khyale/petitAVR/20140113_134701.jpg

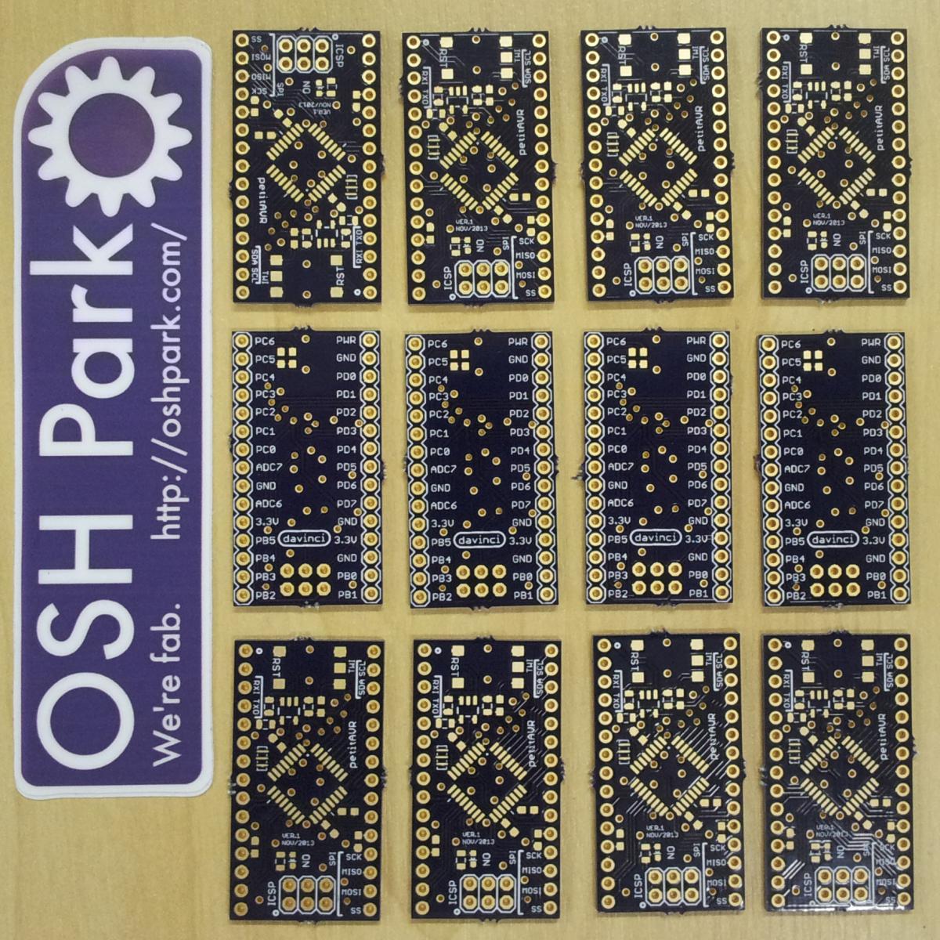
20140113_134701.jpg
