khyale/petitAVR/board-bottom.png

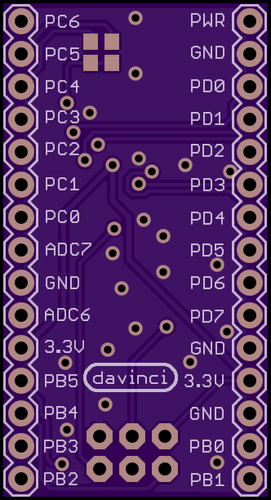
board-bottom.png
