khyale/petitAVR/board-top.png

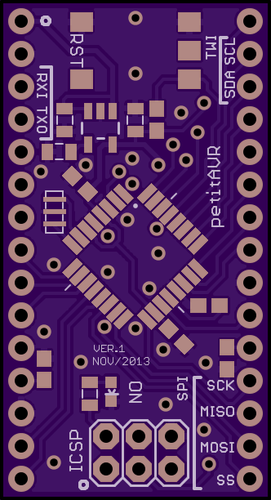
board-top.png
