khyale/petitAVR/circuit.pdf

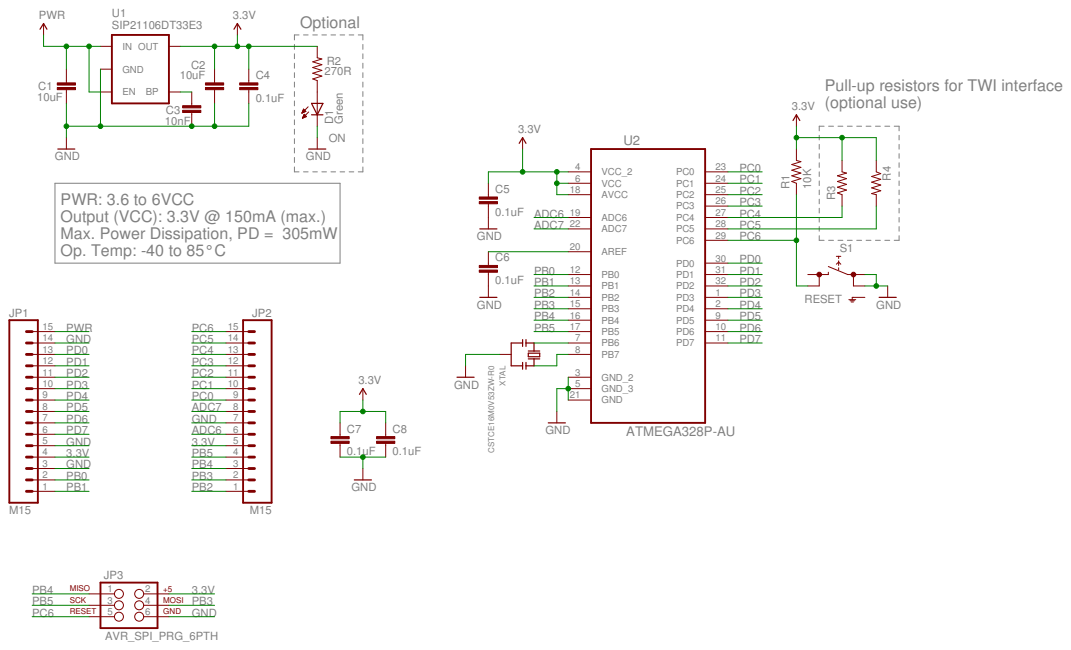
[picture p4: page 1]

PWR: 3.6 to 6VCC
Output (VCC): 3.3V @ 150mA (max.)
Max. Power Dissipation, PD = 305mW
Op. Temp: -40 to 85°C

Davinci Electronic Systems Author: Khyale

20/11/13 16:56 f=0.70 /home/khyale/projetos/petitAVR/board/petitAVR-v1.sch (Sheet: 1/1)
