khyale/petitAVR/eagle/petitAVR-v1.brd

## EAGLE design eagle/petitAVR-v1.brd (2013-11-20)

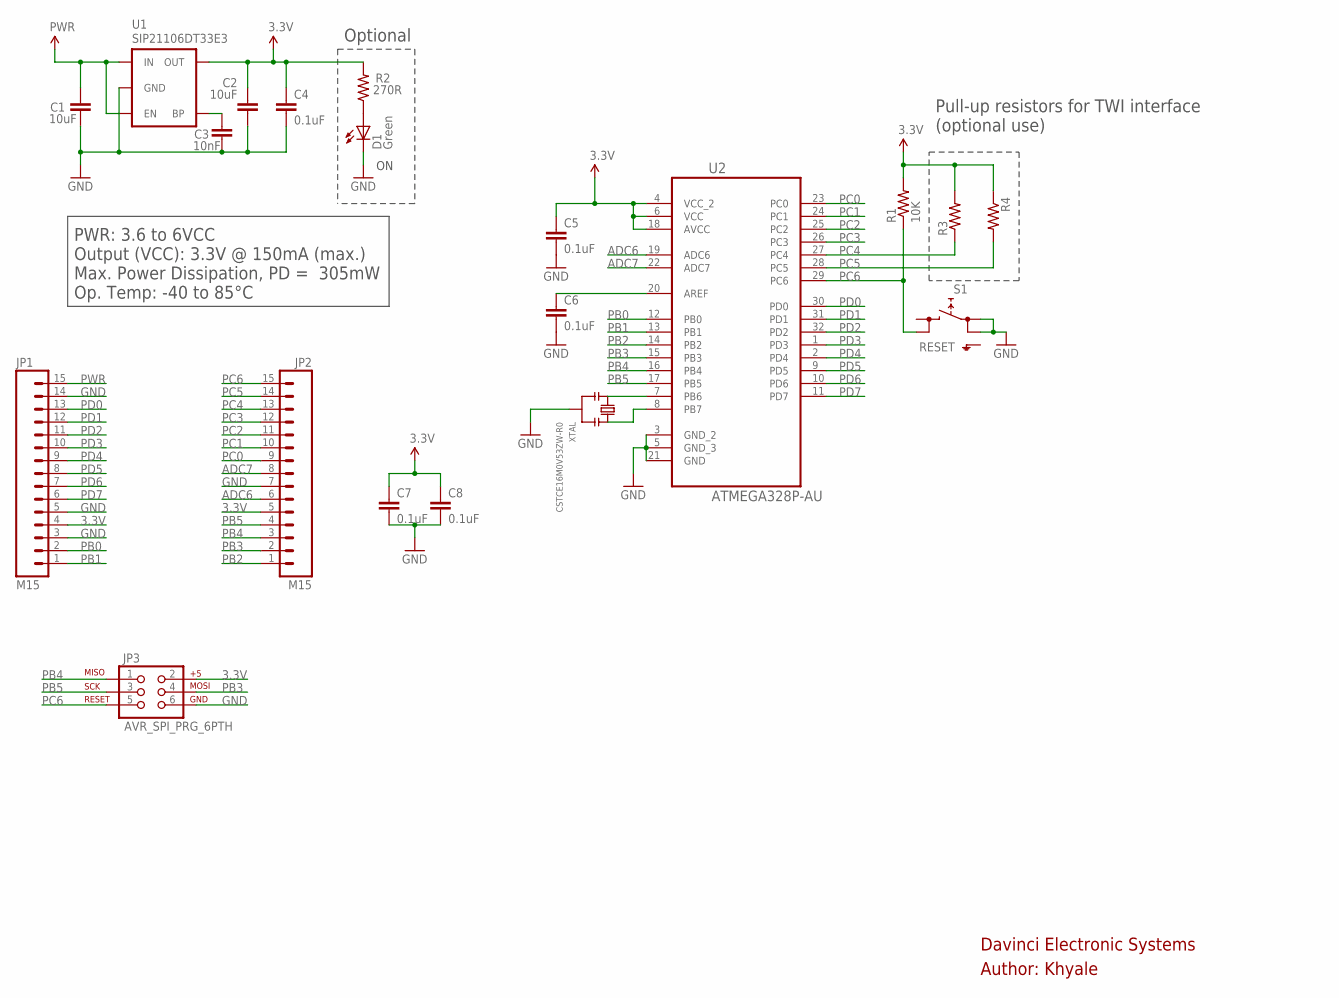
[picture p5: schematic petitAVR-v1.sch]

Parts:
C1, C2: 10uF; 0805; MPN LMK212AB7106MG-T
C3: 10nF; 0805; MPN VJ0805Y103JXQCW1BC
C4, C5, C6, C7, C8: 0.1uF; 0603-CAP; MPN VJ0603Y104KXJCW1BC
D1: Green; LED-0603; MPN VLMG1300-GS08
JP1, JP2: M15; 1X15; MPN 22-28-4151
JP3: AVR_SPI_PRG_6PTH; 2X3; MPN 103328-3
R1: 10K; 0603-RES; MPN ERJ-3EKF1002V
R2: 270R; 0805; MPN ERJ-6GEYJ271V
R3: RESISTOR0603-RES; 0603-RES
R4: RESISTOR0603; 0603-RES
S1: RESET; SKHMPXE010; MPN FSM1LPATR
U1: SIP21106DT33E3; SOT23-5; MPN SIP21106DT-33-E3
U2: ATMEGA328P-AU; QFP80P900X900X120-32N
XTAL: CSTCE16M0V53ZW-R0; CSTCE_V; MPN CSTCE16M0V53ZW-R0

Connections:
3.3V: C2.2, C4.1, C5.1, C7.1, C8.1, JP1.4, JP2.5, JP3.2, R1.2, R2.2, R3.2, R4.1, U1.5 (OUT), U2.4 (VCC_2), U2.6 (VCC), U2.18 (AVCC)
ADC6: JP2.6, U2.19 (ADC6)
ADC7: JP2.8, U2.22 (ADC7)
GND: C1.1, C2.1, C3.1, C4.2, C5.2, C6.2, C7.2, C8.2, D1.C, JP1.3, JP1.5, JP1.14, JP2.7, JP3.6, S1.1 (1.1), S1.2 (1.2), U1.2 (GND), U2.3 (GND_2), U2.5 (GND_3), U2.21 (GND), XTAL.P2
unnamed: D1.A, R2.1
unnamed: U2.7 (PB6), XTAL.P3
unnamed: U2.8 (PB7), XTAL.P1
unnamed: C3.2, U1.4 (BP)
unnamed: C6.1, U2.20 (AREF)
PB0: JP1.2, U2.12 (PB0)
PB1: JP1.1, U2.13 (PB1)
PB2: JP2.1, U2.14 (PB2)
PB3: JP2.2, JP3.4, U2.15 (PB3)
PB4: JP2.3, JP3.1, U2.16 (PB4)
PB5: JP2.4, JP3.3, U2.17 (PB5)
PC0: JP2.9, U2.23 (PC0)
PC1: JP2.10, U2.24 (PC1)
PC2: JP2.11, U2.25 (PC2)
PC3: JP2.12, U2.26 (PC3)
PC4: JP2.13, R3.1, U2.27 (PC4)
PC5: JP2.14, R4.2, U2.28 (PC5)
PC6: JP2.15, JP3.5, R1.1, S1.4 (2.2), U2.29 (PC6)
PD0: JP1.13, U2.30 (PD0)
PD1: JP1.12, U2.31 (PD1)
PD2: JP1.11, U2.32 (PD2)
PD3: JP1.10, U2.1 (PD3)
PD4: JP1.9, U2.2 (PD4)
PD5: JP1.8, U2.9 (PD5)
PD6: JP1.7, U2.10 (PD6)
PD7: JP1.6, U2.11 (PD7)
PWR: C1.2, JP1.15, U1.1 (IN), U1.3 (EN)

Notes on the sheet:
PWR: 3.6 to 6VCC Output (VCC): 3.3V @ 150mA (max.) Max. Power Dissipation, PD = 305mW Op. Temp: -40 to 85°C
Pull-up resistors for TWI interface (optional use)
Davinci Electronic Systems
Optional
Author: Khyale

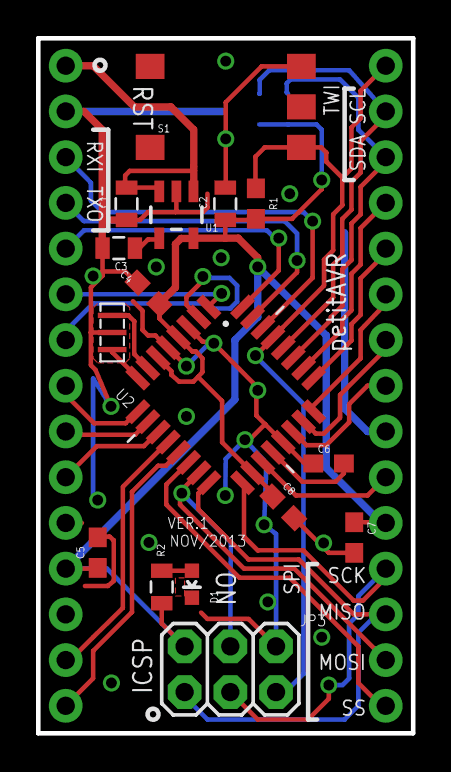
[picture p6: board petitAVR-v1.brd from above]

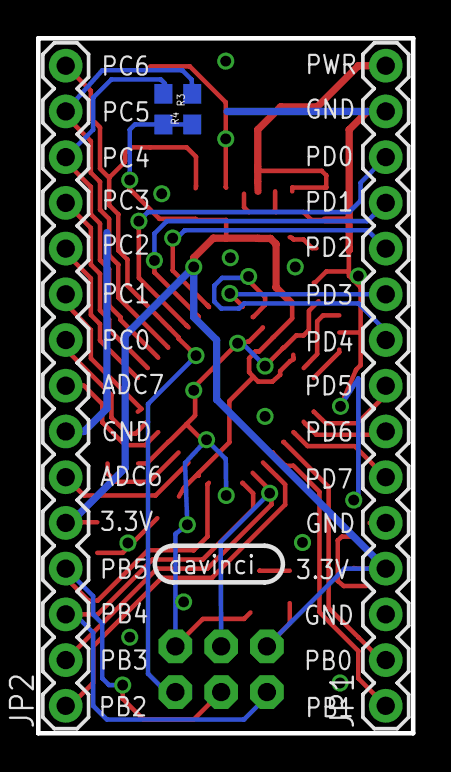
[picture p7: board petitAVR-v1.brd from below]

Board: 2 copper layers, 20.8 x 38.6 mm, 20 parts (4 on the bottom side), 31 nets.
